florin2520/Scrolling_display/README.md

# Scrolling_display
video: https://www.youtube.com/watch?v=rzXzmcrgy1s
