florin2520/Scrolling_display/Scrolling_display.X/PinConfigurations.png

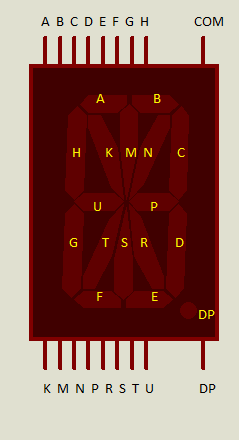
Scrolling_display.X/PinConfigurations.png
