florin2520/Scrolling_display/(list of files, cad)

Other CAD files:
Scrolling_display.X/dist/default/production/Scrolling_display.X.production.obj
