florin2520/Scrolling_display/(list of files, drawings)

Other design files:
Scrolling_display.X/Scrolling_display.pdsprj
